atuleu/giant-midi-keyboard/README.md

# Giant MIDI Keyboard

This project is an open source Giant MIDI Keyboard, using an Arduino Micro, LUFA, and some small devices.
