atuleu/giant-midi-keyboard/(list of files, cad)

Other CAD files:
cad/mechanics/Base.ipt
cad/mechanics/Base_Left.ipt
cad/mechanics/Base_Right.ipt
cad/mechanics/Base_Under.ipt
cad/mechanics/Captor.ipt
cad/mechanics/Control_Box.ipt
cad/mechanics/Do.ipt
cad/mechanics/Do_Plain.ipt
cad/mechanics/Drawings.idw
cad/mechanics/Fa.ipt
cad/mechanics/Feinte.ipt
cad/mechanics/Hidder_Left.ipt
cad/mechanics/Hidder_Right.ipt
cad/mechanics/La.ipt
cad/mechanics/Mi.ipt
cad/mechanics/Re.ipt
cad/mechanics/Si.ipt
cad/mechanics/Sol.ipt
cad/mechanics/giant-midi-keyboard.iam
