atuleu/giant-midi-keyboard/cad/elec/front-panel/front-panel.kicad_pcb

## KiCad design cad/elec/front-panel/front-panel.kicad_pcb (2015-04-02)

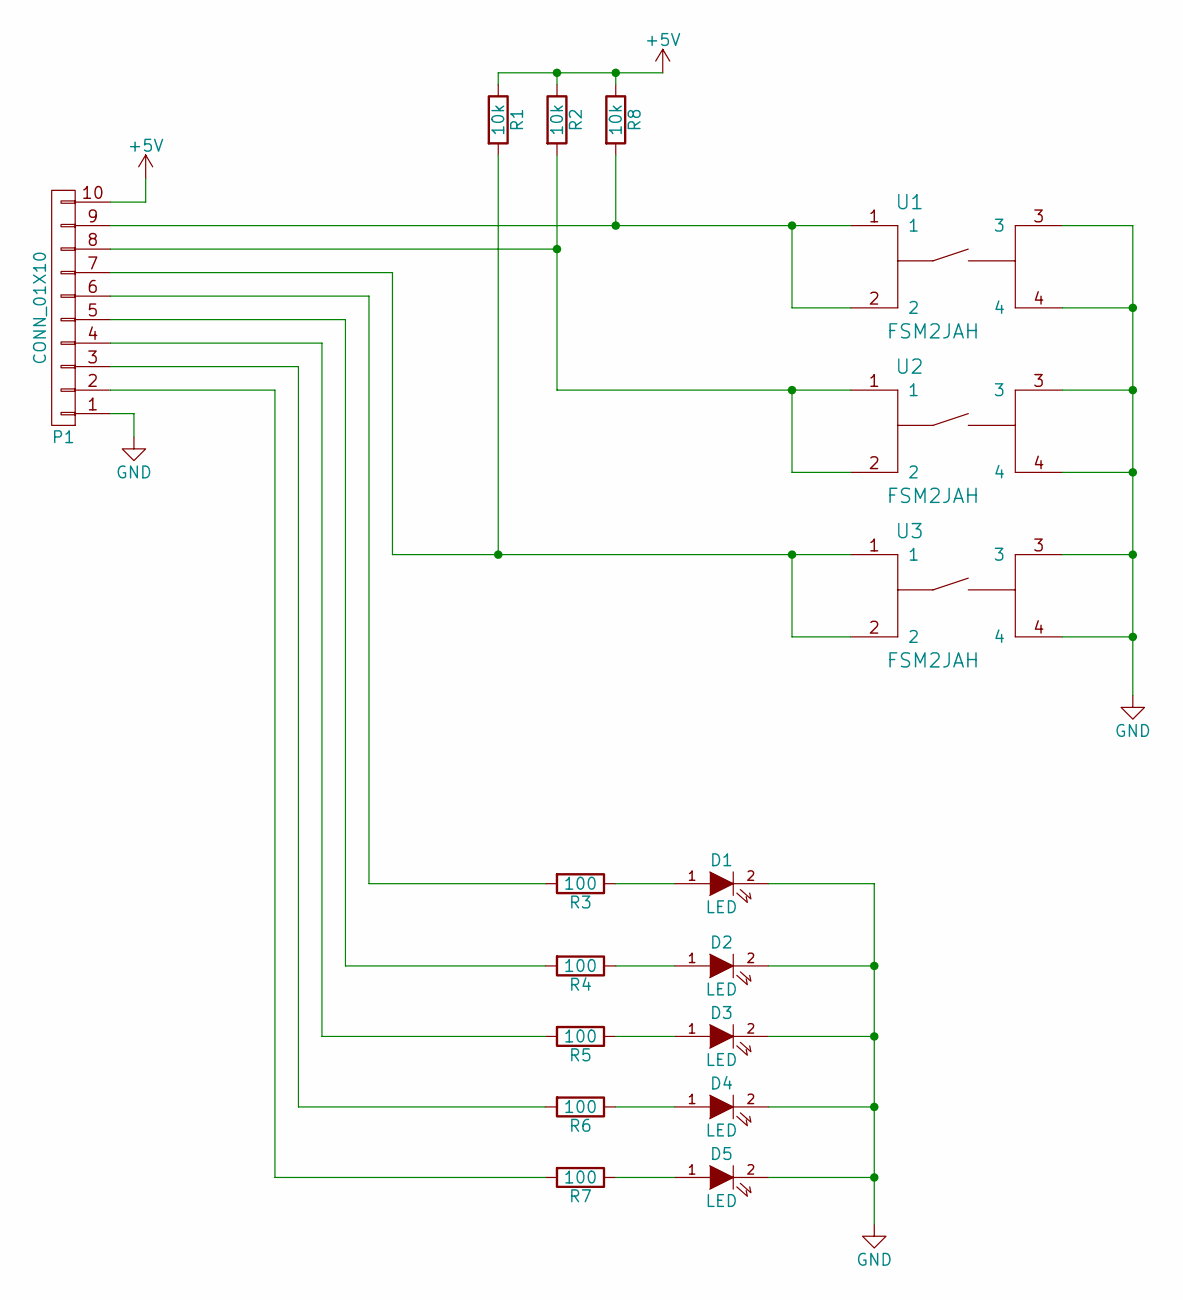
[picture p1: schematic front-panel.sch]

Parts:
D1, D2, D3, D4, D5: LED; LED-5MM; Part Number LC503FBL1-15Q-A3-00001
P1: CONN_01X10; Header_2x5
R1, R2, R8: 10k; Resistor_Horizontal_RM10mm
R3, R4, R5, R6, R7: 100; Resistor_Horizontal_RM10mm
U1, U2, U3: FSM2JAH; Part Number FSM2JAH

Connections:
+5V: P1.10, R1.1, R2.1, R8.1
GND: D1.2 (K), D2.2 (K), D3.2 (K), D4.2 (K), D5.2 (K), P1.1, U1.3, U1.4, U2.3, U2.4, U3.3, U3.4
unnamed: D1.1 (A), R3.1
unnamed: D2.1 (A), R4.1
unnamed: D3.1 (A), R5.1
unnamed: D4.1 (A), R6.1
unnamed: D5.1 (A), R7.1
unnamed: P1.2, R7.2
unnamed: P1.3, R6.2
unnamed: P1.4, R5.2
unnamed: P1.5, R4.2
unnamed: P1.6, R3.2
unnamed: P1.7, R1.2, U3.1, U3.2
unnamed: P1.8, R2.2, U2.1, U2.2
unnamed: P1.9, R8.2, U1.1, U1.2

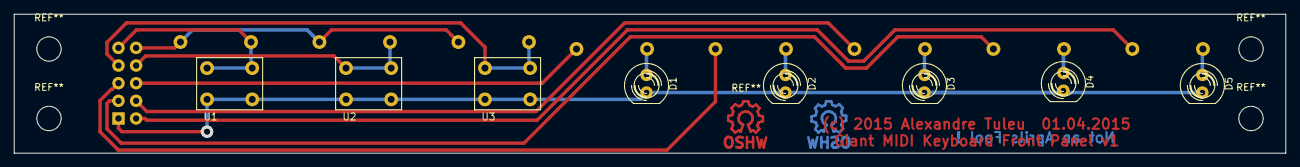
[picture p2: board front-panel.kicad_pcb from above]

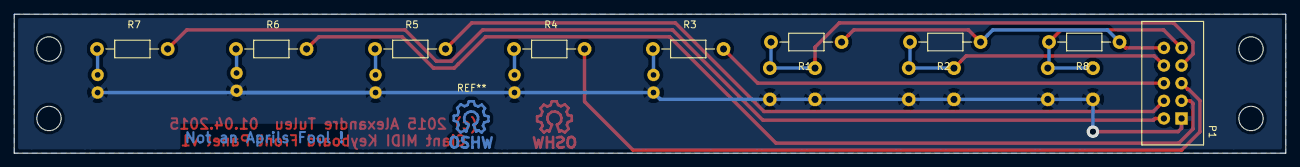
[picture p3: board front-panel.kicad_pcb from below]

Board: 2 copper layers, 183.0 x 20.0 mm, 17 parts (9 on the bottom side), 15 nets.
