atuleu/giant-midi-keyboard/cad/elec/USB-controller/giant_midi_keyboard.kicad_pcb

## KiCad design cad/elec/USB-controller/giant_midi_keyboard.kicad_pcb (2015-04-02)

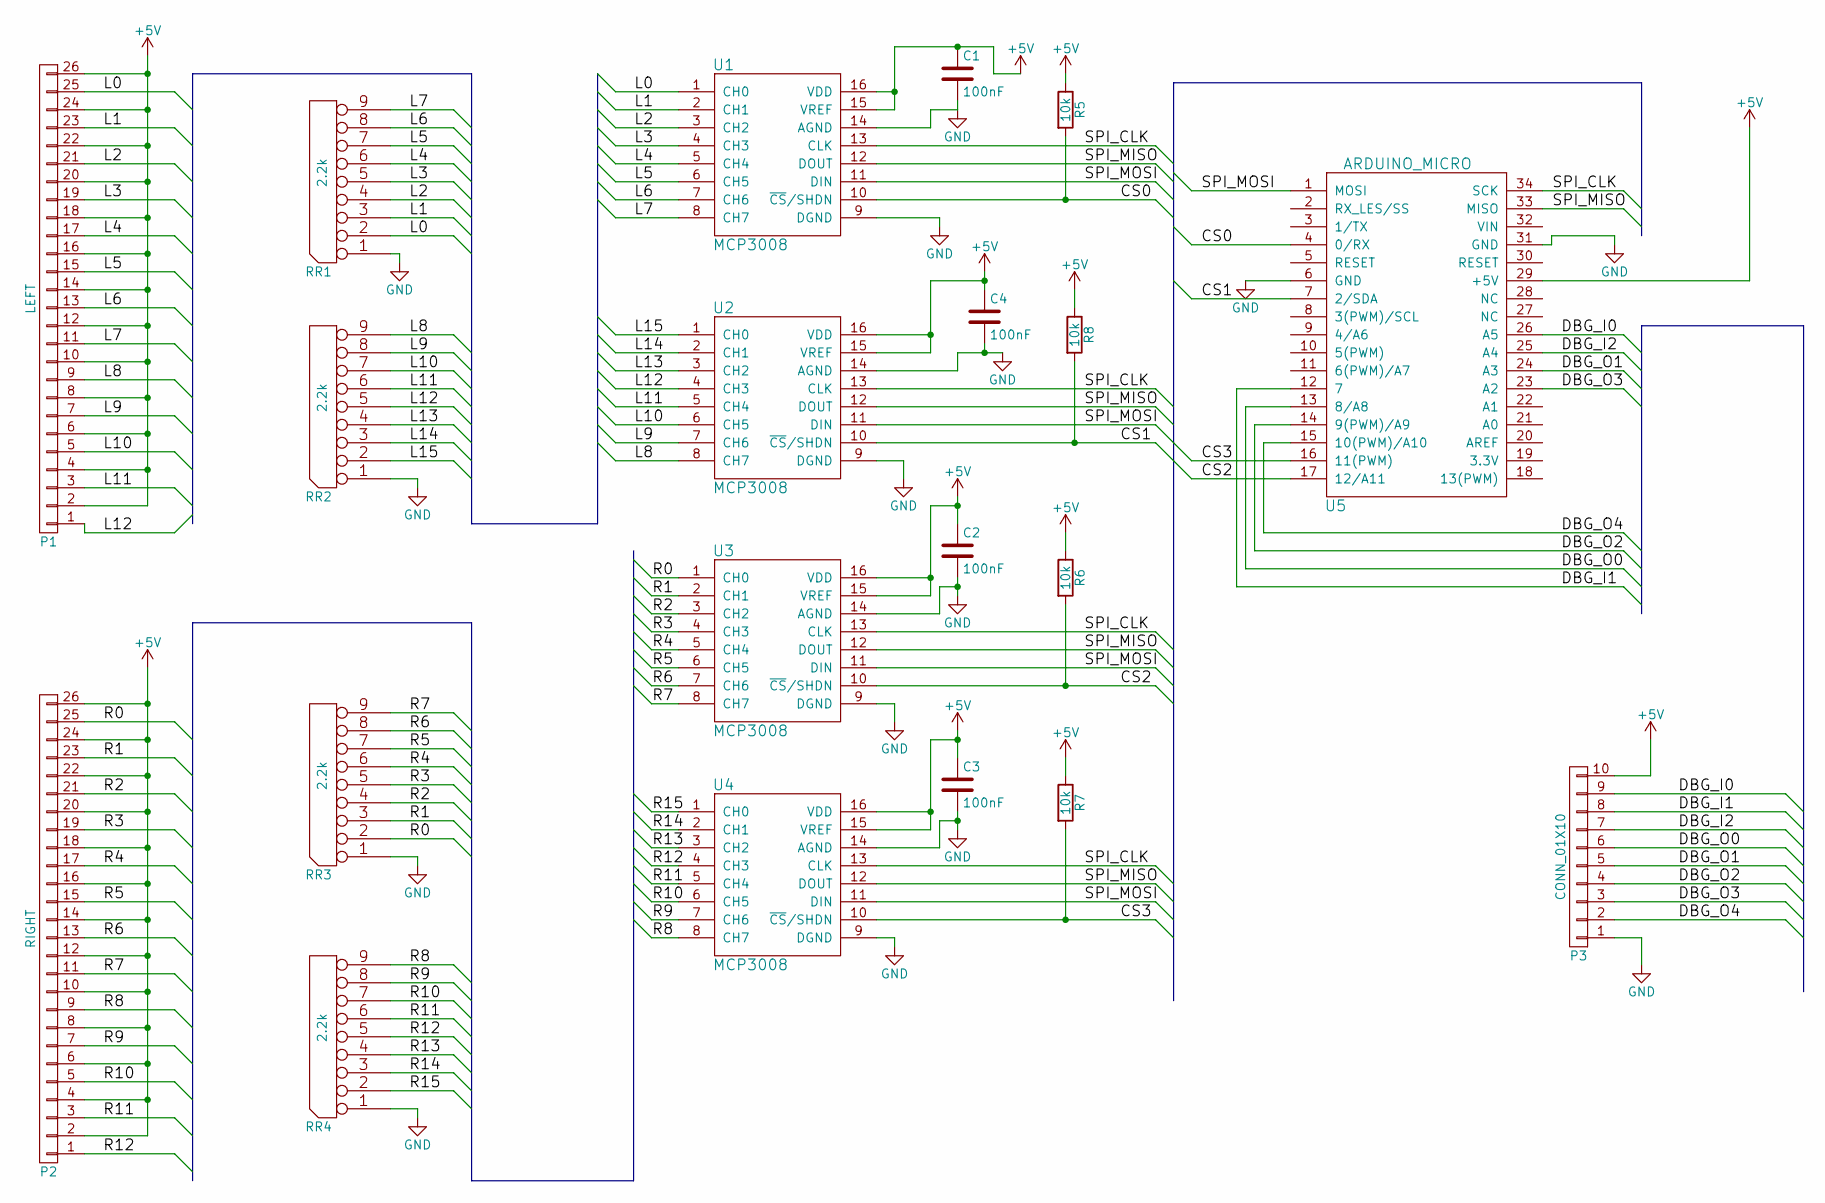
[picture p4: schematic giant_midi_keyboard.sch]

Parts:
C1, C2, C3, C4: 100nF; C_Disc_D6_P5; Part Number MC0805B104K500A2.54MM
P1: LEFT; Header_2x13; Part Number T821126A1S100CEU
P2: RIGHT; Header_2x13; Part Number T821126A1S100CEU
P3: CONN_01X10; Header_2x5
R5, R6, R7, R8: 10k; Resistor_Horizontal_RM10mm
RR1, RR2, RR3, RR4: 2.2k; SIP9_Housing_BigPads; Part Number 4609X-101-222LF
U1, U2, U3, U4: MCP3008; DIP-16__300_ELL; Part Number MCP3008-I/P
U5: ARDUINO_MICRO; Part Number Arduino Micro

Connections:
+5V: C1.1, C2.1, C3.1, C4.1, P1.2, P1.4, P1.6, P1.8, P1.10, P1.12, P1.14, P1.16, P1.18, P1.20, P1.22, P1.24, P1.26, P2.2, P2.4, P2.6, P2.8, P2.10, P2.12, P2.14, P2.16, P2.18, P2.20, P2.22, P2.24, P2.26, P3.10, R5.1, R6.1, R7.1, R8.1, U1.15 (VREF), U1.16 (VDD), U2.15 (VREF), U2.16 (VDD), U3.15 (VREF), U3.16 (VDD), U4.15 (VREF), U4.16 (VDD), U5.29 (+5V)
/CS0: R5.2, U1.10 (~CS~/SHDN), U5.4 (0/RX)
/CS1: R8.2, U2.10 (~CS~/SHDN), U5.7 (2/SDA)
/CS2: R6.2, U3.10 (~CS~/SHDN), U5.17 (12/A11)
/CS3: R7.2, U4.10 (~CS~/SHDN), U5.16 (11(PWM))
/DBG_I0: P3.9, U5.26 (A5)
/DBG_I1: P3.8, U5.12 (7)
/DBG_I2: P3.7, U5.25 (A4)
/DBG_O0: P3.6, U5.13 (8/A8)
/DBG_O1: P3.5, U5.24 (A3)
/DBG_O2: P3.4, U5.14 (9(PWM)/A9)
/DBG_O3: P3.3, U5.23 (A2)
/DBG_O4: P3.2, U5.15 (10(PWM)/A10)
/L0: P1.25, RR1.2, U1.1 (CH0)
/L1: P1.23, RR1.3, U1.2 (CH1)
/L2: P1.21, RR1.4, U1.3 (CH2)
/L3: P1.19, RR1.5, U1.4 (CH3)
/L4: P1.17, RR1.6, U1.5 (CH4)
/L5: P1.15, RR1.7, U1.6 (CH5)
/L6: P1.13, RR1.8, U1.7 (CH6)
/L7: P1.11, RR1.9, U1.8 (CH7)
/L8: P1.9, RR2.9, U2.8 (CH7)
/L9: P1.7, RR2.8, U2.7 (CH6)
/L10: P1.5, RR2.7, U2.6 (CH5)
/L11: P1.3, RR2.6, U2.5 (CH4)
/L12: P1.1, RR2.5, U2.4 (CH3)
/L13: RR2.4, U2.3 (CH2)
/L14: RR2.3, U2.2 (CH1)
/L15: RR2.2, U2.1 (CH0)
/R0: P2.25, RR3.2, U3.1 (CH0)
/R1: P2.23, RR3.3, U3.2 (CH1)
/R2: P2.21, RR3.4, U3.3 (CH2)
/R3: P2.19, RR3.5, U3.4 (CH3)
/R4: P2.17, RR3.6, U3.5 (CH4)
/R5: P2.15, RR3.7, U3.6 (CH5)
/R6: P2.13, RR3.8, U3.7 (CH6)
/R7: P2.11, RR3.9, U3.8 (CH7)
/R8: P2.9, RR4.9, U4.8 (CH7)
/R9: P2.7, RR4.8, U4.7 (CH6)
/R10: P2.5, RR4.7, U4.6 (CH5)
/R11: P2.3, RR4.6, U4.5 (CH4)
/R12: P2.1, RR4.5, U4.4 (CH3)
/R13: RR4.4, U4.3 (CH2)
/R14: RR4.3, U4.2 (CH1)
/R15: RR4.2, U4.1 (CH0)
/SPI_CLK: U1.13 (CLK), U2.13 (CLK), U3.13 (CLK), U4.13 (CLK), U5.34 (SCK)
/SPI_MISO: U1.12 (DOUT), U2.12 (DOUT), U3.12 (DOUT), U4.12 (DOUT), U5.33 (MISO)
/SPI_MOSI: U1.11 (DIN), U2.11 (DIN), U3.11 (DIN), U4.11 (DIN), U5.1 (MOSI)
GND: C1.2, C2.2, C3.2, C4.2, P3.1, RR1.1 (COM), RR2.1 (COM), RR3.1 (COM), RR4.1 (COM), U1.9 (DGND), U1.14 (AGND), U2.9 (DGND), U2.14 (AGND), U3.9 (DGND), U3.14 (AGND), U4.9 (DGND), U4.14 (AGND), U5.6 (GND), U5.31 (GND)

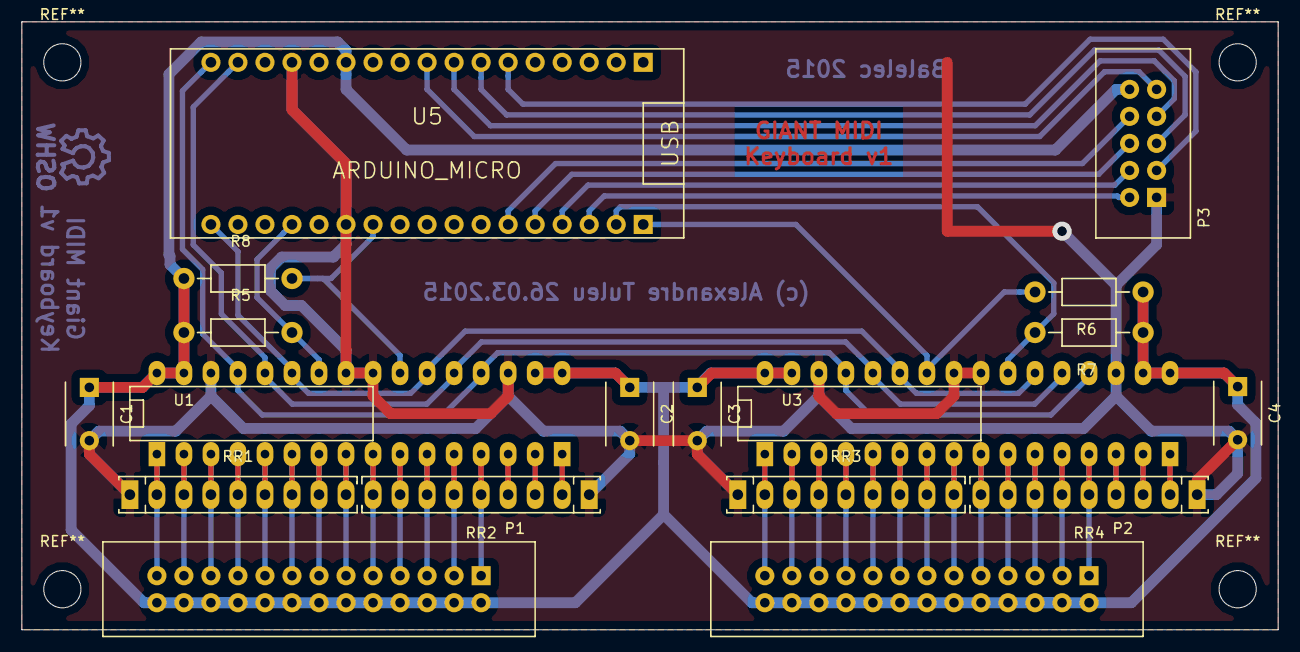
[picture p5: board giant_midi_keyboard.kicad_pcb from above]

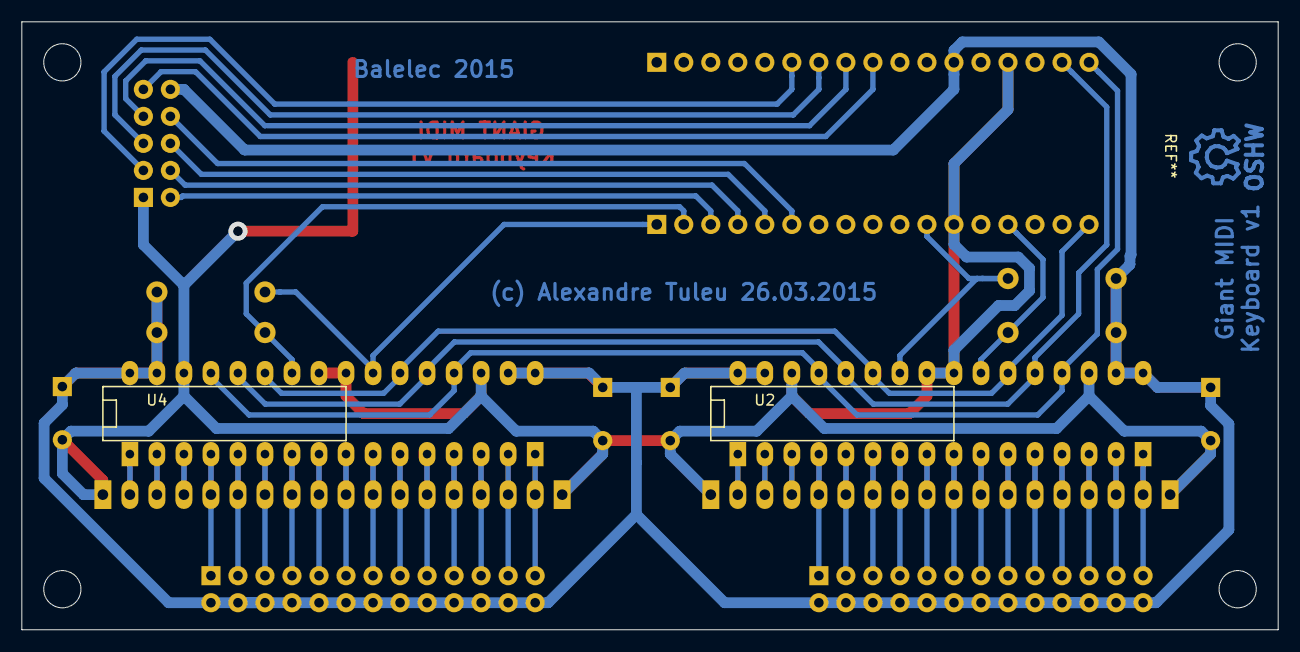
[picture p6: board giant_midi_keyboard.kicad_pcb from below]

Board: 2 copper layers, 118.1 x 57.1 mm, 20 parts (2 on the bottom side), 49 nets.
