atuleu/giant-midi-keyboard/(commit log)

2015-03-26 Adds first schematics
    [giant_midi_keyboard.kicad_pcb, giant_midi_keyboard.sch]
2015-03-27 Draws first draft of schematics and layout.
    [giant_midi_keyboard.sch]
2015-03-28 Adds all base pieces
    [Base.ipt, Captor.ipt, Do.ipt, Do_Plain.ipt, Fa.ipt, La.ipt, Mi.ipt, Re.ipt]
2015-03-28 Places all components
    [Captor.ipt, Do.ipt, Fa.ipt, Feinte.ipt, La.ipt, Mi.ipt, Re.ipt, Si.ipt]
2015-03-28 Adds hole for cables
    [Base.ipt, giant-midi-keyboard.iam]
2015-04-02 Moves project to subdirectory
    [giant_midi_keyboard.kicad_pcb, giant_midi_keyboard.sch]
2015-04-02 Adds front panel board
    [front-panel.kicad_pcb, front-panel.sch]
2015-04-02 Updates usb board for use with panel board
    [giant_midi_keyboard.kicad_pcb, giant_midi_keyboard.sch]
2015-04-02 Makes the board ready for manual engraving
    [front-panel.kicad_pcb, front-panel.sch]
2015-04-02 Adds panelized version
    [USB-controller-panelized.kicad_pcb, front-panel-panelized.kicad_pcb]
2015-04-07 Corrects a bad sketches
    [Base.ipt, giant-midi-keyboard.iam]
2015-04-07 Adds Box and Base_Under
    [Base.ipt, Base_Left.ipt, Base_Right.ipt, Base_Under.ipt, Control_Box.ipt, Hidder_Left.ipt, Hidder_Right.ipt, giant-midi-keyboard.iam]
2015-04-07 Adds Drawing
    [Drawings.idw]
2015-04-15 Adds LUFA and arduino-cmake submodules
2015-04-15 Adds skeletons for Arduino FW
2015-04-15 Adds basic configuration
    Most of the thing comes from trial and error testing from
    atuleu/giant-snes-gamepad
    [main.c]
2015-04-15 Adds UserInterface button reading
    It is a bit more complex as it seems, because we have to make sure that
    there is no bounce of the push button. The button has to be pushed for
    more than 50 ms in order to trigger a Push events.
    There is no support for release events.
2015-04-17 Removes arduino-cmake submodule
2015-04-17 Switches to a Low-Level driver
2015-04-20 Uses arduino ISP instead of dragon
2015-04-20 Fixes a small bug where display was not correctly set
    [USB.c, UserInterface.c]
2015-04-20 Adds minimal interface for reading SPI
2015-04-22 Fixes bug that crashed device
    [KeyReader.c, KeyReader.h, main.c]
2015-04-24 Adds enum for errors
    [UserInterface.c, UserInterface.h]
2015-04-24 Adds skeleton for a calibrator tool
2015-04-24 Moves calibrator to tools/calibrator
2015-04-27 Adds Interface for USB device
2015-04-27 Makes application cleaner to error
    [GMKDevice.cpp, GMKDevice.h, MainWindow.cpp, MainWindow.h, main.cpp]
2015-04-27 Implements device look up
2015-04-27 Fixes swap between product and manufacturer strings
    [Descriptor.c]
2015-04-27 Implements auto selection of devices
2015-04-27 fixes bug with refreshes
    [MainWindow.cpp, MainWindow.h, main.cpp]
2015-04-28 Switches to Qt5
2015-04-28 Adds Oscilloscope slots interface
2015-04-29 Fixes small UI glitches
    [MainWindow.cpp, Oscilloscope.cpp, Oscilloscope.h]
2015-04-29 Fixes device reading
2015-04-29 Prints with symbols
2015-05-06 fixes stupid anoying bug
    [GMKDevice.cpp, main.c]
2015-05-06 Swaps the key pins
    It was an error on the schematics
    [KeyReader.c]
