atuleu/giant-midi-keyboard/(notices)

Notices in the files:
cad/elec/front-panel-panelized.kicad_pcb:
(c) 2015 Alexandre Tuleu 01.04.2015
